urukakanko/RsPico_round_lcd/README.md

# RsPicoラウンド液晶モジュール

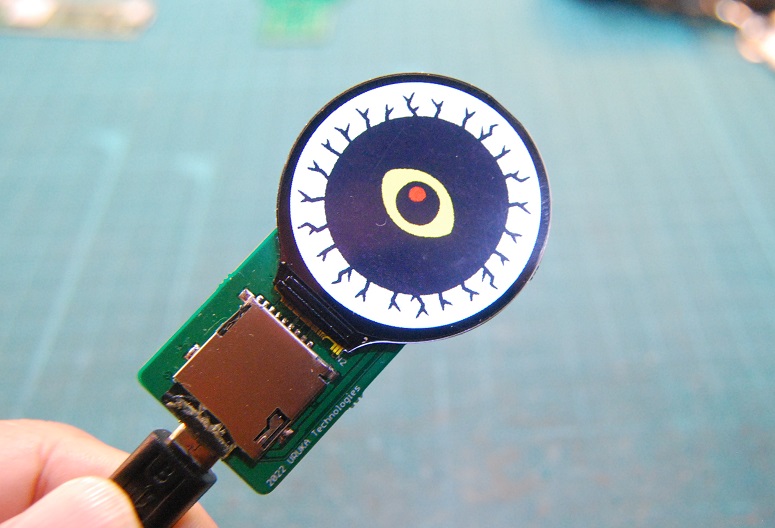
[picture p1: gaiken.jpg]

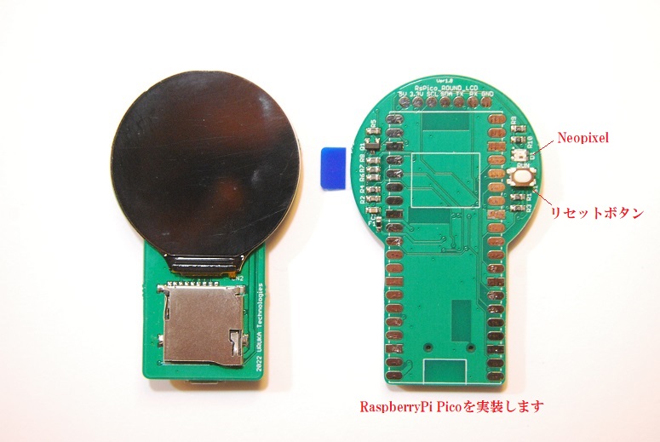
[picture p2: gaiken2.JPG]

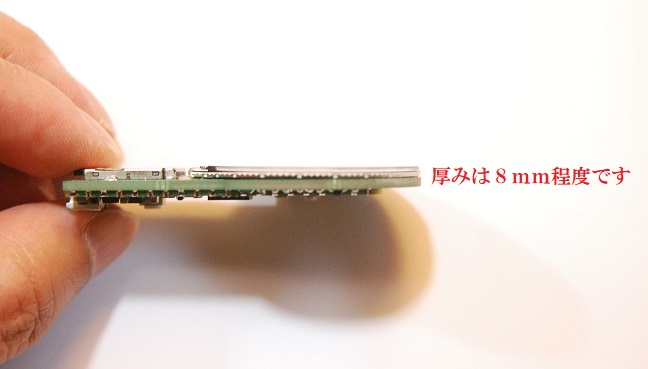
[picture p3: gaiken3.JPG]


ラズベリーパイPicoを使用して1.28インチ240ｘ240ドットの円形液晶を駆動する基板モジュールです。

円形液晶の裏にラズベリーパイPicoを配置してしまいました。

ラズベリーパイPicoの大きさの分だけこの基板も大きくなってしまったので、メモリーカードスロットを乗せてみました。

おまけで、RUN信号によるリセットボタンとNeopixel（フルカラーLCD)を１個搭載しています。

円形液晶にはGC9A01というコントローラーが使用されていますが、対応したグラフィックライブラリが数種類公開されています。

本モジュールは「グラフィックライブラリの使い方を理解して液晶モジュールを駆動出来る人」をターゲットにしております。

# <span style="color: red;">注意！！（必ずお読み下さい）</span>

本品は基本的な電子回路の仕組みを理解した方を対象とした、電子部品がむき出しの半完成キットです。
電子部品は電源電圧や極性を間違えたり、部品を破損させたり部品端子をショートさせた場合、発熱・発煙・発火に至る場合もあります。
間違った使い方をすると危険である事を理解された方のみご使用ください。
趣味の電子工作向けに製作しておりますので、製品への組込みや日常生活へ組込んでのご使用はお止め下さい。

# 形状および回路図

以下に外形イメージを示します

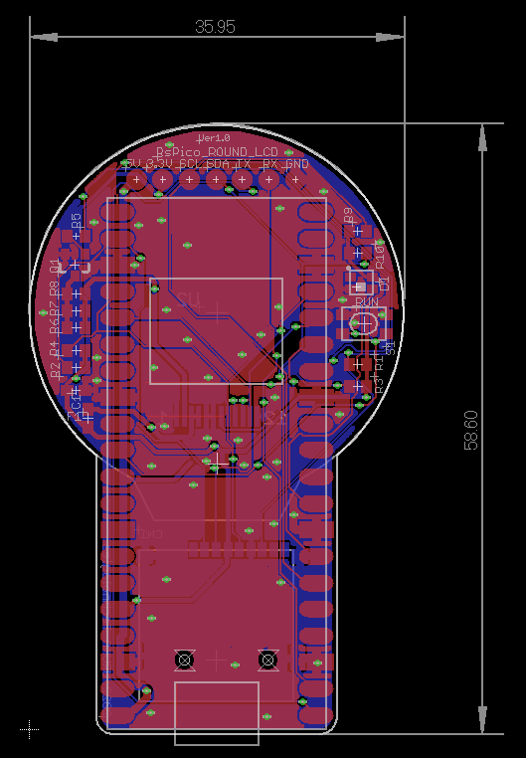
[picture p4: pcb_image.png]


以下に回路図を示します

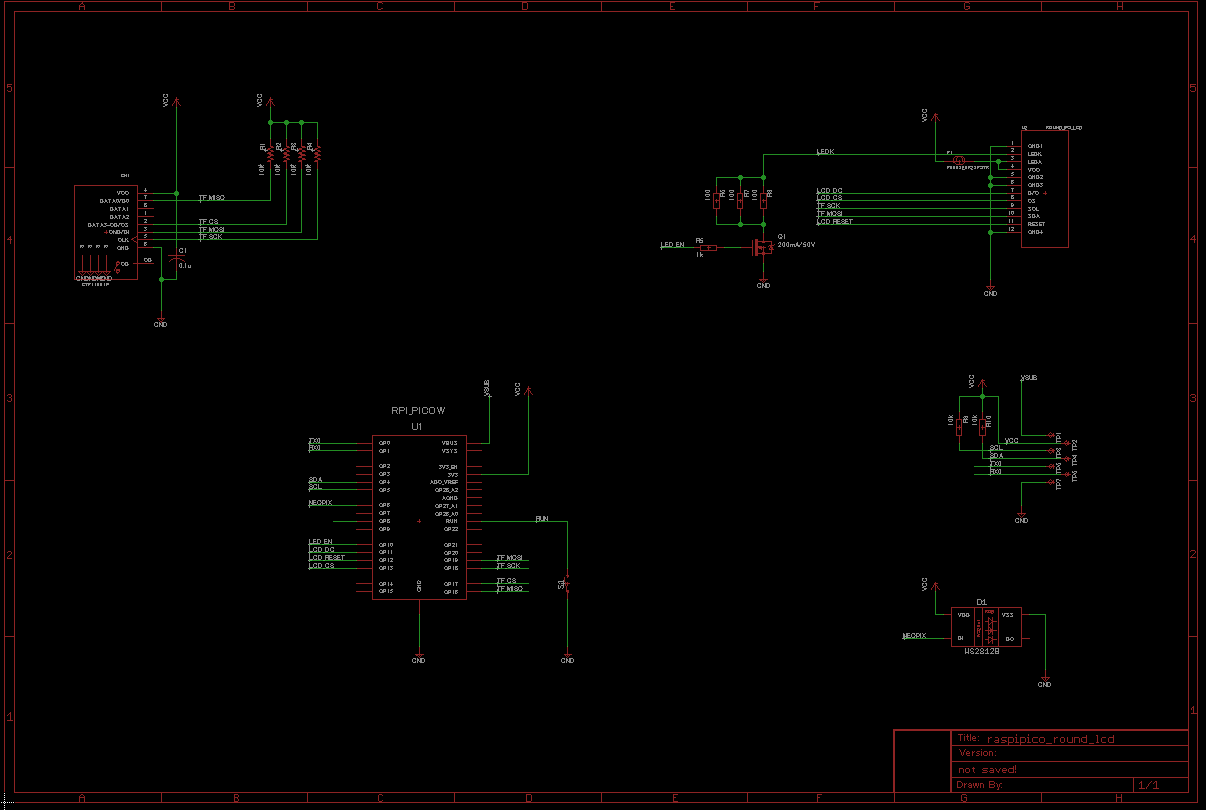
[picture p5: schematic.png]


# ピンアサイン

ラズベリーパイPico とLCDの制御信号とのピン接続は以下となります。

- SCLK:GP18

- MOSI:GP19

- DC:GP11

- CS:GP13

- RST:GP12

- バックライト:GP10　　バックライトLEDのPIN設定は必ず行ってください。未設定だと端子がハイインピーダンスとなりバックライトが不安定になります。

ラズベリーパイPicoとメモリーカード制御信号とのピン接続は以下となります。

- SCLK:GP18（LCDと共通）
- MOSI:GP19（LCDと共通）
- CS:GP17

フルカラーLED　Neopixelの接続は以下となります。

- Neopixel:GP6

また、I2C接続などを想定した外部接続端子があります

注意：リード線をハンダ付けするパットとして使用します　コネクタやピンヘッダは挿せません。　

また、1PINおよび2PINはセンサーなど小型周辺モジュールを駆動するための電源出力端子です。本モジュールを駆動するための電源入力としては設計しておりません。

- 1PIN : 5V

- 2PIN : 3.3V

- 3PIN : GP4 (I2C SDAを想定)

- 4PIN : G9P5(I2C SCLを想定)

- 5PIN : GP0(UART TX0を想定)

- 6PIN : GP1(UART RX0を想定)

- 7PIN : GND 

# 使用するための準備

CircuitPython　や　Arduino IDEでの動作を確認しています。
まず最初に以下のページでCircuitPythonのファームウェアをダウンロードしてラズベリーパイPicoに書き込んで下さい。

https://circuitpython.org/board/raspberry_pi_pico/

（書き込み操作を間違えたりプログラムの不具合で動かなくなった場合、ファームウェアを書き直してみてください）

# Arduino IDEで使用するための手順

以下サイトを参考にRaspberrypi Pico用のライブラリをインストールして下さい。

https://github.com/earlephilhower/arduino-pico

Arduino IDEでのグラフィックライブラリについては主にlovyan様のLovyanGFXにて動作確認をしています。

https://github.com/lovyan03/LovyanGFX

以下、Arduino IDEで動作させる場合のサンプルコードです。

https://github.com/urukakanko/RsPico_round_lcd/tree/main/RsPico_round_lcd_ClockSample

他、GC9A01に対応したライブラリが使用可能と考えています。

# Circuit Pythonで画像表示させる手順とサンプル

2か所のサイトからライブラリファイルの入手が必要となります。

まず　Adafruit_CircuitPython_Bundle-7 を入手します。

https://github.com/adafruit/Adafruit_CircuitPython_Bundle/releases/tag/20221007

zipファイルを解凍して、libフォルダに保存されている「adafruit_imageload」フォルダをラズベリーパイPicoに出来ているlibフォルダにコピーします。

（サンプルはbitmap表示するだけですが、他の機能などは必要に応じてライブラリをコピーしてください）

次に　液晶ドライバGC9A01を駆動するために、circuitpython-community-bundle-7　を入手します。

https://github.com/adafruit/CircuitPython_Community_Bundle/releases/tag/20220924

zipファイルを解凍して、libフォルダに保存されている「gc9a01.mpy」をラズベリーパイPicoに出来ているlibフォルダにコピーします

サンプルコード「code.py」は以下に保存しました。上記libフォルダおよび表示するイメージデータを保存したimageフォルダも保存していますので、フォルダごとラズベリーパイPicoにコピーすると良いでしょう。なおadafruit_imageloadで表示可能なイメージデータは8bit（256色）bitmapです。　

https://github.com/urukakanko/RsPico_round_lcd/tree/main/RsPicocircuitpython_sample

Circuit Pythonで動作させる場合の注意：バックライトLEDに使用しているポートGP10ですがエラー等でプログラムが中断した場合に不定状態となり、バックライトの点灯が不安定になる事があります。気になる場合は大変お手数ですがGP10を10KΩ程度でプルアップしてください。ポート不定時はバックライトが点灯状態になります。（次期改版で対応いたします）

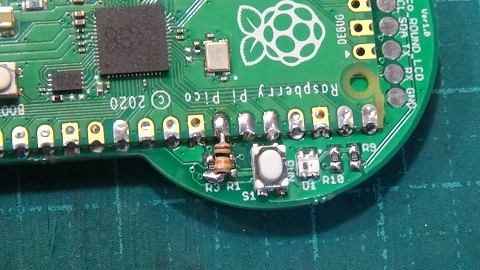
[picture p6: pullup.jpg]


# LCD表示動画

https://youtu.be/9OK_MoBfMhk

# こちらもそーたメイ様のつくるっちに対応して頂きました

http://sohta02.web.fc2.com/familyday.html

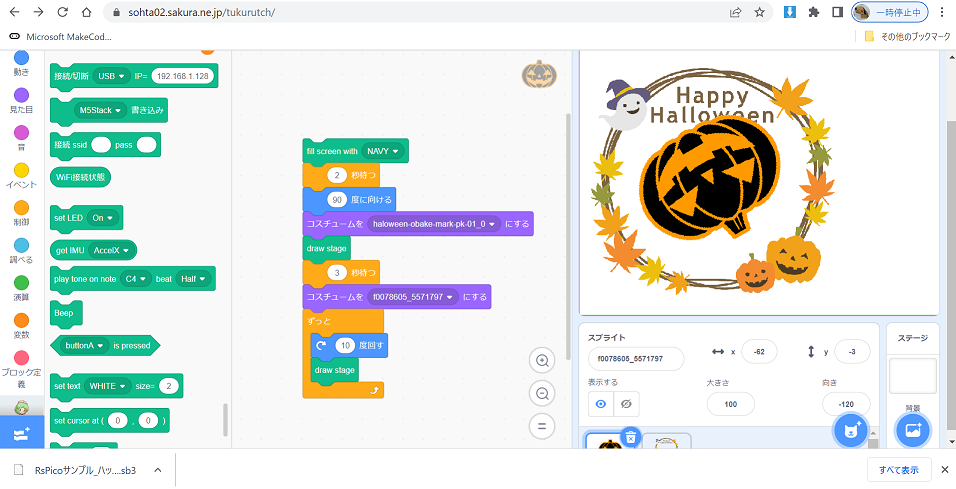
[picture p7: tukurutti.png]


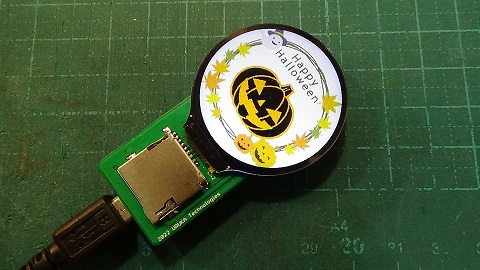
[picture p8: kabocha.jpg]


対応ファームはコチラです。予めラズベリーパイPicoに.uf2ファイルを書込んでください。

https://github.com/urukakanko/RsPico_round_lcd/blob/main/src.ino.elf.uf2

Chromeブラウザで以下つくるっち画面を開き「拡張機能を追加」から「M5Series」を追加してください

https://sohta02.sakura.ne.jp/tukurutch/

サンプルプログラムは以下です

https://github.com/urukakanko/M5Stamp_round_lcd/blob/main/M5Stamp%E3%82%B5%E3%83%B3%E3%83%97%E3%83%AB_%E3%83%8F%E3%83%83%E3%83%94%E3%83%BC%E3%83%8F%E3%83%AD%E3%82%A6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

# スイッチサイエンス　マーケットプレイスにて販売しています

https://www.switch-science.com/products/8432/

# 製作者

ウルカテクノロジー
Hiroyuki Sunagawa

https://www.facebook.com/URUKA-Technologies-105478404379918
