urukakanko/RsPico_round_lcd/raspipico_round_lcd.pdf

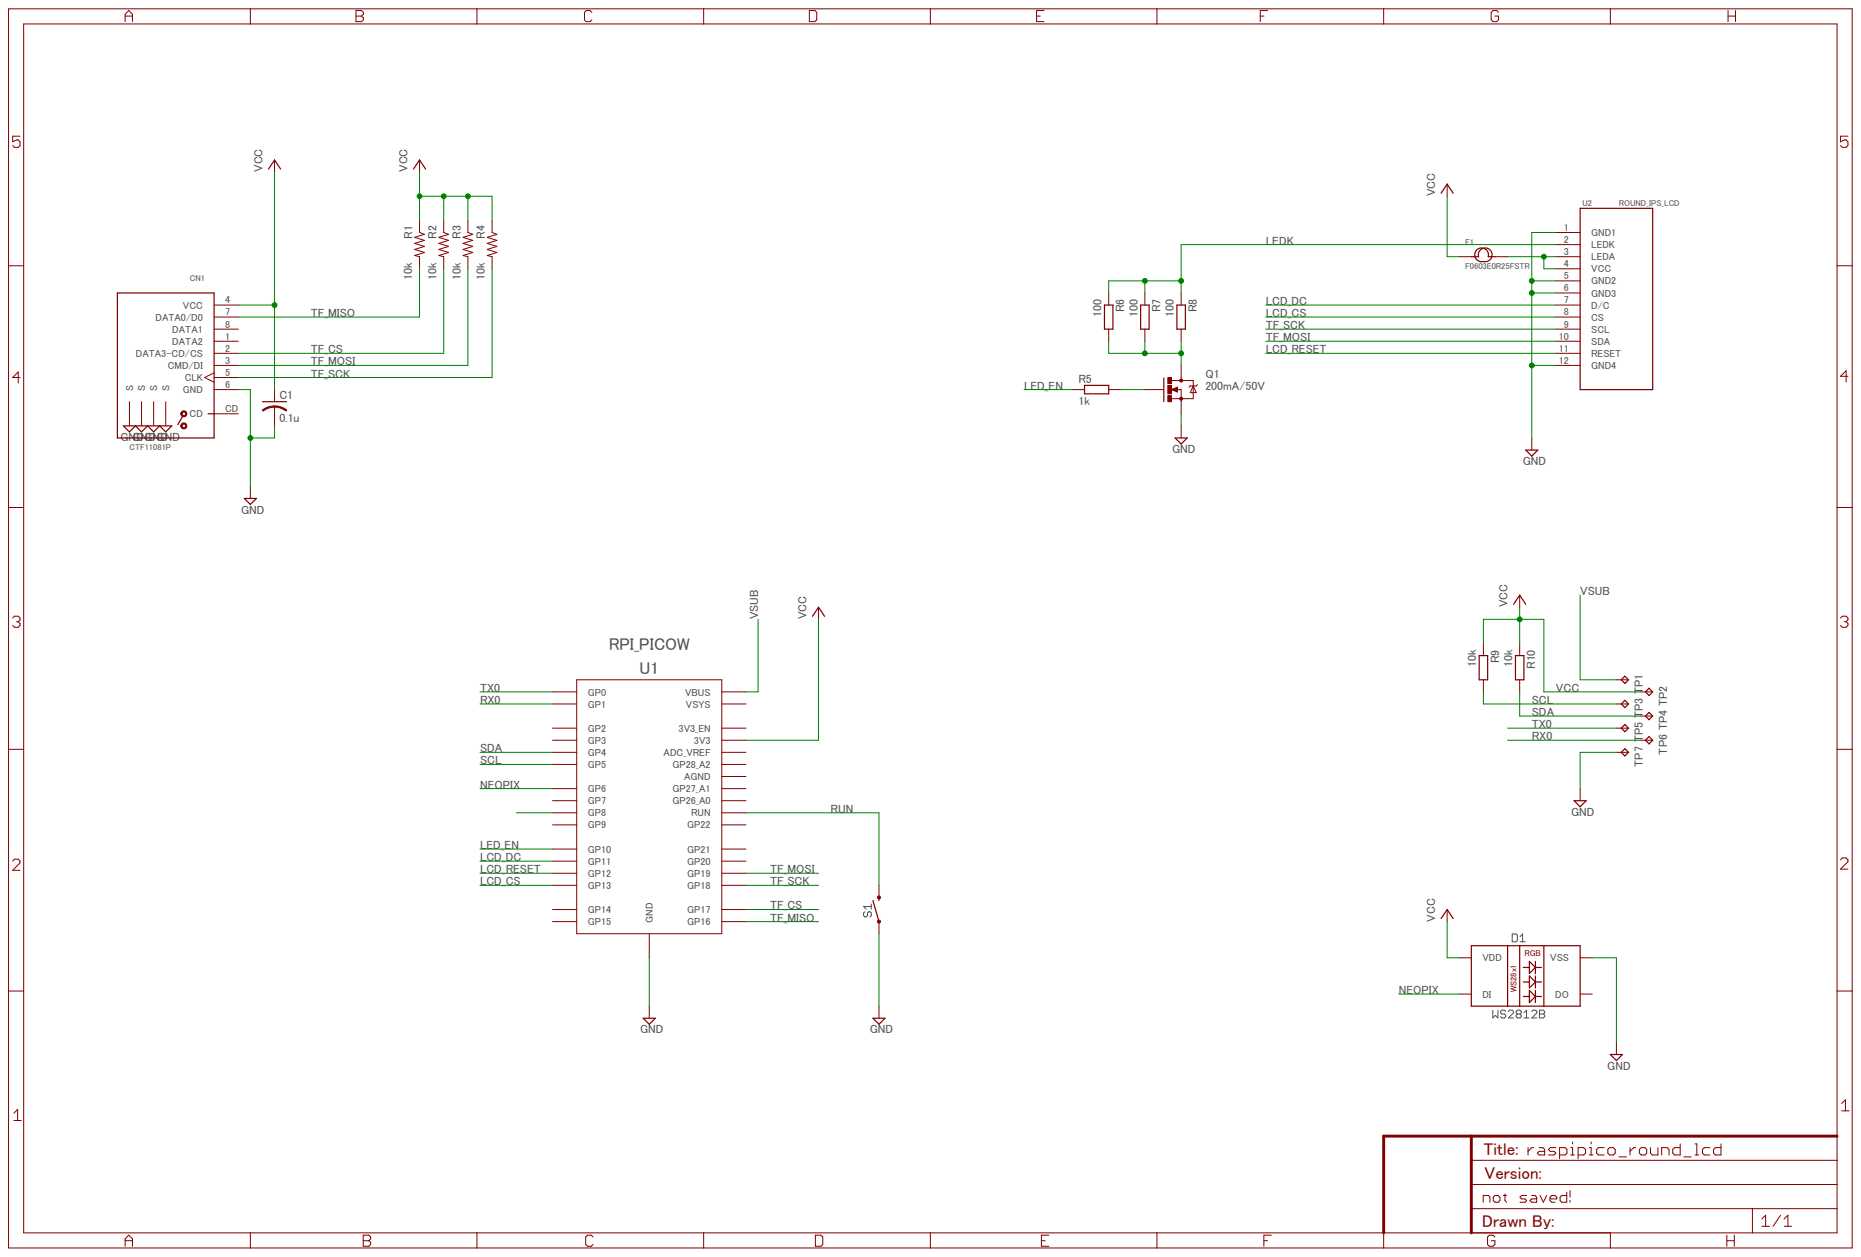
[picture p9: page 1]

10k 10k ROUND_IPS_LCD 100 100 200mA/50V 1k VCC GND VCC VCC GND GND GND GND 0.1u 10k 10k 10k 10k VCC GND VCC VCC GNGDNGDNGDND GND 100 F0603E0R25FSTR R9 R10 LEDK 2 LEDA 3 VCC 4 GND1 1 U2GND2 5 GND3 6 D/C 7 CS 8 SCL 9 SDA 10 RESET 11 GND4 12 R8R7 Q1 R5 C1 R1R2R3R4 DI DO VDD VSS GP0 GP1 GP2 GP3 GP4 GP5 GP6 GP7 GP8 GP9 GP10 GP11 GP12 GP13 GP14 GP15 GP16 GP17 GP18 GP19 GP20 GP21 GP22 RUN GP26_A0 GP27_A1 AGND GP28_A2 ADC_VREF 3V3 3V3_EN VSYS VBUS GND U1 RPI_PICOW TP1 TP2 TP3 TP4 TP5 TP6 TP7 R6 F1 CD CD CLK 5 CMD/DI 3 DATA0/D0 7 DATA1 8 DATA2 1 DATA3-CD/CS 2 GND SSSS6 VCC 4 CN1 CTF11081P SDA SDA SCL SCL LEDK LCD_DC LCD_DC LCD_CS LCD_CS LCD_RESET LCD_RESET LED_EN LED_EN VSUB VSUB VCC TF_MISO TF_MISO TF_MOSI TF_MOSI TF_MOSI TF_SCK TF_SCK TF_SCK RX0 RX0 TX0 TX0 RUN TF_CS TF_CS NEOPIX NEOPIX Drawn By: Title: Version: RGB WS28x1
