urukakanko/RsPico_round_lcd/RsPicocircuitpython_sample/image/test.bmp

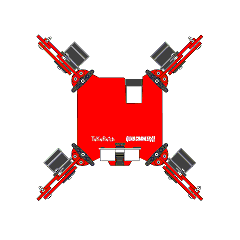
RsPicocircuitpython_sample/image/test.bmp
